schuylersg/FastDataAcquisition/README.md

FastDataAcquisition
===================

A high speed (1 GSPS+) data acquisition circuit. This project is currently in development. All schematics and boards are not finalized.
