schuylersg/FastDataAcquisition/FastDataAcq.brd

## EAGLE design FastDataAcq.brd (2013-11-19)

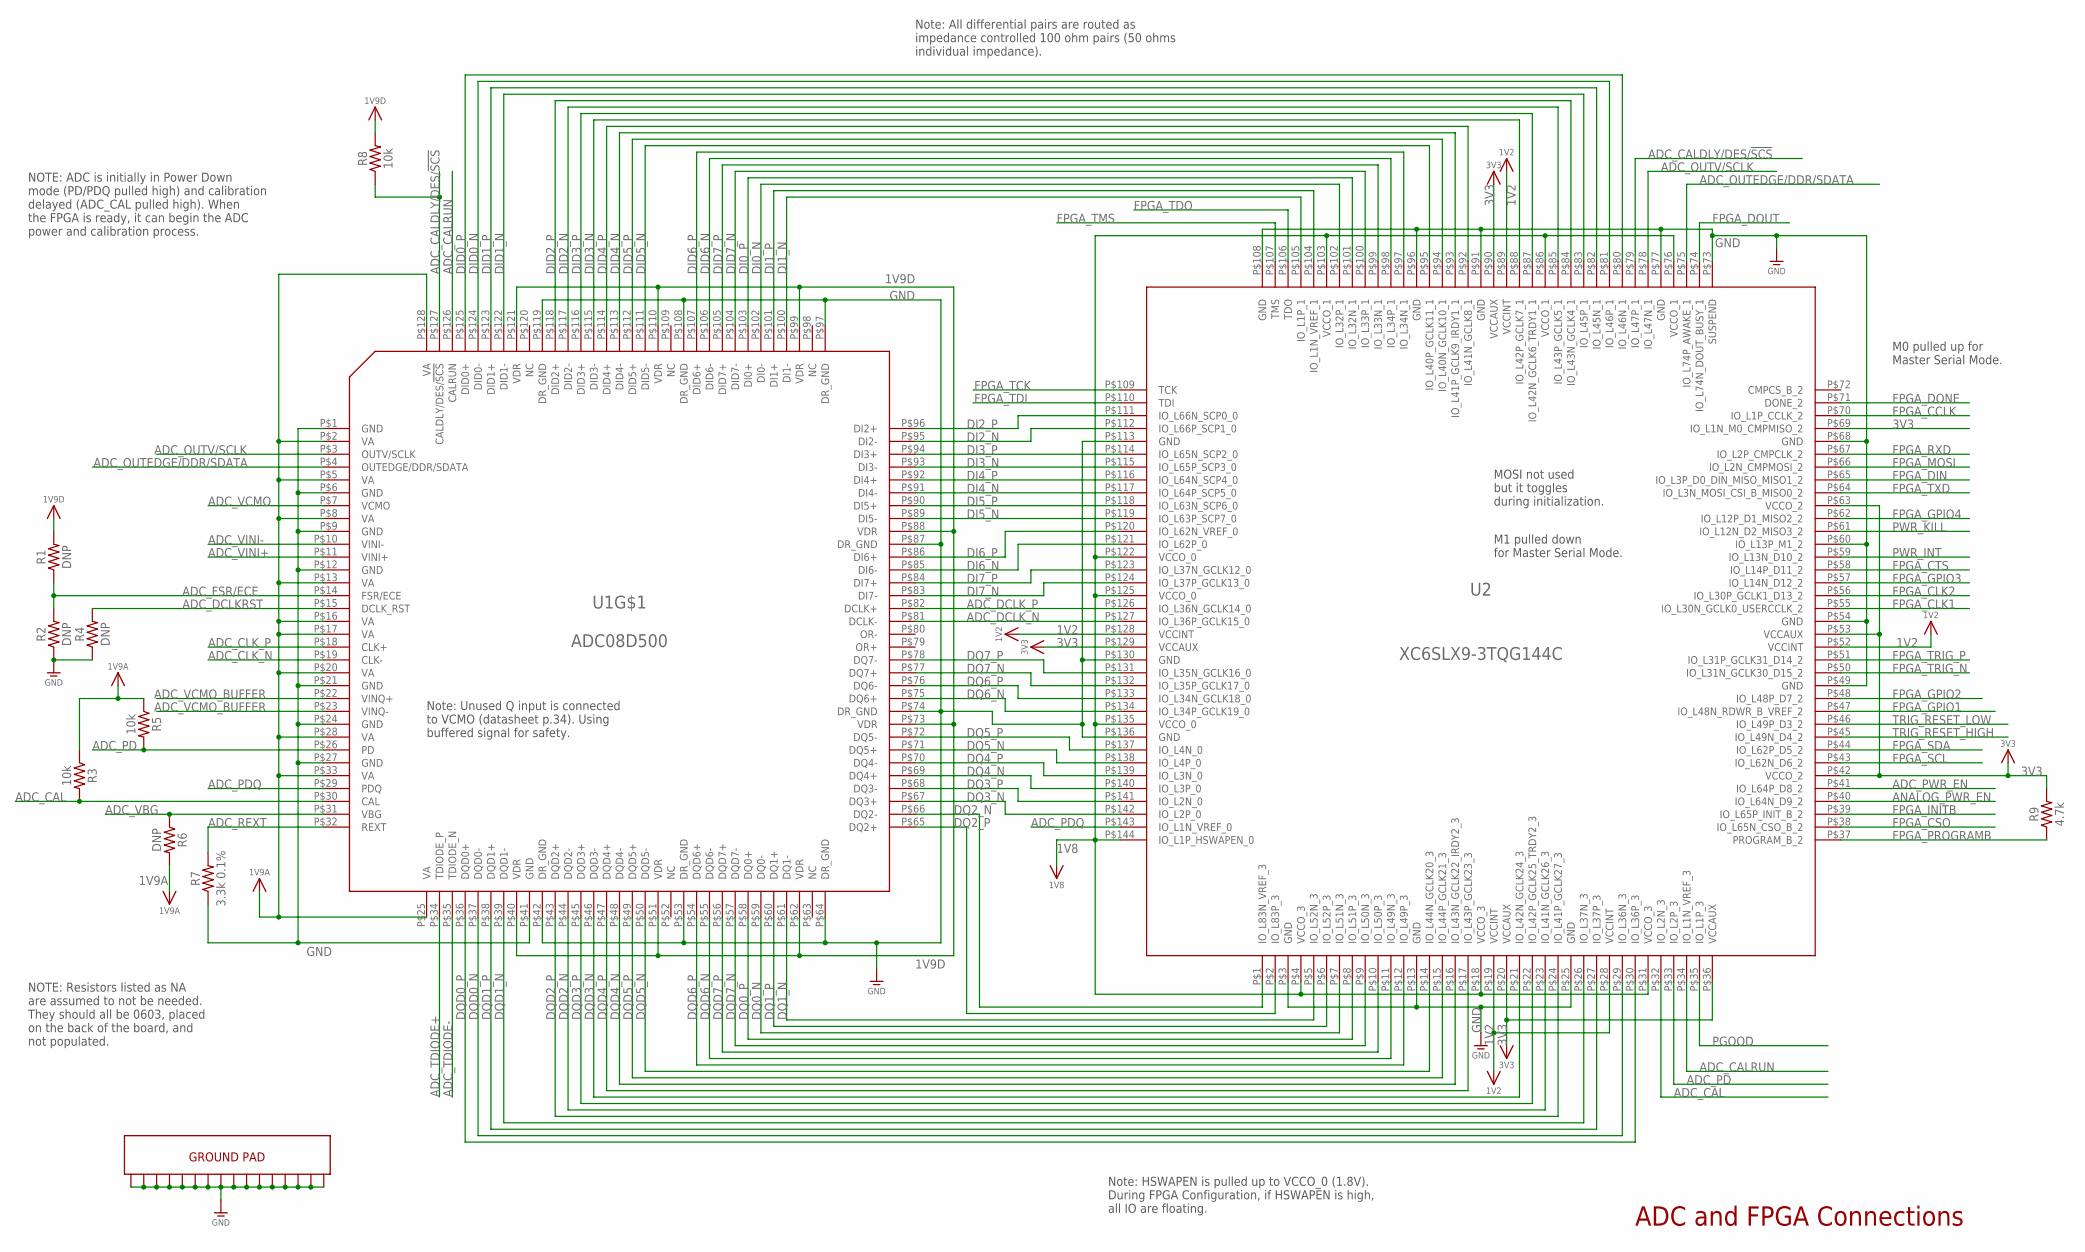
[picture p4: schematic FastDataAcq.sch, sheet 1, ADC to FPGA]

Parts:
R1, R2, R4, R6: DNP; R0603
R3, R5, R8: 10k; R0201; MANPARTNUMBER RC0603J103CS
R7: 3.3k 0.1%; R0603; PARTNUMBER P3.3KDBCT-ND
R9: 4.7k; R0201; MANPARTNUMBER ERJ-1GNJ472C
U1: ADC08D500; 128HLQFP; PARTNUMBER ADC08D500CIYB/NOPB-ND
U2: XC6SLX9-3TQG144C; TQG144

Connections:
1V2: U2.P$19 (VCCINT), U2.P$28 (VCCINT), U2.P$52 (VCCINT), U2.P$89 (VCCINT), U2.P$128 (VCCINT); also elsewhere on the board
1V8: U2.P$4 (VCCO_3), U2.P$18 (VCCO_3), U2.P$31 (VCCO_3), U2.P$76 (VCCO_1), U2.P$86 (VCCO_1), U2.P$103 (VCCO_1), U2.P$122 (VCCO_0), U2.P$125 (VCCO_0), U2.P$135 (VCCO_0), U2.P$144 (IO_L1P_HSWAPEN_0); also elsewhere on the board
1V9A: R3.1, R5.1, R6.2, U1.P$2 (VA), U1.P$5 (VA), U1.P$8 (VA), U1.P$13 (VA), U1.P$16 (VA), U1.P$17 (VA), U1.P$20 (VA), U1.P$25 (VA), U1.P$28 (VA), U1.P$33 (VA), U1.P$128 (VA); also elsewhere on the board
1V9D: R1.2, R8.2, U1.P$40 (VDR), U1.P$51 (VDR), U1.P$62 (VDR), U1.P$73 (VDR), U1.P$88 (VDR), U1.P$99 (VDR), U1.P$110 (VDR), U1.P$121 (VDR); also elsewhere on the board
3V3: R9.2, U2.P$20 (VCCAUX), U2.P$36 (VCCAUX), U2.P$42 (VCCO_2), U2.P$53 (VCCAUX), U2.P$63 (VCCO_2), U2.P$69 (IO_L1N_M0_CMPMISO_2), U2.P$90 (VCCAUX), U2.P$129 (VCCAUX); also elsewhere on the board
ADC_CAL: R3.2, U1.P$30 (CAL), U2.P$32 (IO_L2N_3)
ADC_CALDLY/DES/!SCS: R8.1, U1.P$127 (CALDLY/DES/!SCS), U2.P$79 (IO_L47P_1)
ADC_CALRUN: U1.P$126 (CALRUN), U2.P$34 (IO_L1N_VREF_3)
ADC_CLK_N: U1.P$19 (CLK-); also elsewhere on the board
ADC_CLK_P: U1.P$18 (CLK+); also elsewhere on the board
ADC_DCLKRST: R4.2, U1.P$15 (DCLK_RST)
ADC_DCLK_N: U1.P$81 (DCLK-), U2.P$127 (IO_L36P_GCLK15_0)
ADC_DCLK_P: U1.P$82 (DCLK+), U2.P$126 (IO_L36N_GCLK14_0)
ADC_FSR/ECE: R1.1, R2.2, U1.P$14 (FSR/ECE)
ADC_OUTEDGE/DDR/SDATA: U1.P$4 (OUTEDGE/DDR/SDATA), U2.P$75 (IO_L74P_AWAKE_1)
ADC_OUTV/SCLK: U1.P$3 (OUTV/SCLK), U2.P$78 (IO_L47N_1)
ADC_PD: R5.2, U1.P$26 (PD), U2.P$33 (IO_L2P_3)
ADC_PDQ: U1.P$29 (PDQ), U2.P$143 (IO_L1N_VREF_0)
ADC_PWR_EN: U2.P$41 (IO_L64P_D8_2); also elsewhere on the board
ADC_REXT: R7.2, U1.P$32 (REXT)
ADC_TDIODE+: U1.P$34 (TDIODE_P); also elsewhere on the board
ADC_TDIODE-: U1.P$35 (TDIODE_N); also elsewhere on the board
ADC_VBG: R6.1, U1.P$31 (VBG)
ADC_VCMO: U1.P$7 (VCMO); also elsewhere on the board
ADC_VCMO_BUFFER: U1.P$22 (VINQ+), U1.P$23 (VINQ-); also elsewhere on the board
ADC_VINI+: U1.P$11 (VINI+); also elsewhere on the board
ADC_VINI-: U1.P$10 (VINI-); also elsewhere on the board
ANALOG_PWR_EN: U2.P$40 (IO_L64N_D9_2); also elsewhere on the board
DI0_N: U1.P$102 (DI0-), U2.P$102 (IO_L32P_1)
DI0_P: U1.P$103 (DI0+), U2.P$101 (IO_L32N_1)
DI1_N: U1.P$100 (DI1-), U2.P$105 (IO_L1P_1)
DI1_P: U1.P$101 (DI1+), U2.P$104 (IO_L1N_VREF_1)
DI2_N: U1.P$95 (DI2-), U2.P$112 (IO_L66P_SCP1_0)
DI2_P: U1.P$96 (DI2+), U2.P$111 (IO_L66N_SCP0_0)
DI3_N: U1.P$93 (DI3-), U2.P$115 (IO_L65P_SCP3_0)
DI3_P: U1.P$94 (DI3+), U2.P$114 (IO_L65N_SCP2_0)
DI4_N: U1.P$91 (DI4-), U2.P$117 (IO_L64P_SCP5_0)
DI4_P: U1.P$92 (DI4+), U2.P$116 (IO_L64N_SCP4_0)
DI5_N: U1.P$89 (DI5-), U2.P$119 (IO_L63P_SCP7_0)
DI5_P: U1.P$90 (DI5+), U2.P$118 (IO_L63N_SCP6_0)
DI6_N: U1.P$85 (DI6-), U2.P$121 (IO_L62P_0)
DI6_P: U1.P$86 (DI6+), U2.P$120 (IO_L62N_VREF_0)
DI7_N: U1.P$83 (DI7-), U2.P$124 (IO_L37P_GCLK13_0)
DI7_P: U1.P$84 (DI7+), U2.P$123 (IO_L37N_GCLK12_0)
DID0_N: U1.P$124 (DID0-), U2.P$81 (IO_L46P_1)
DID0_P: U1.P$125 (DID0+), U2.P$80 (IO_L46N_1)
DID1_N: U1.P$122 (DID1-), U2.P$83 (IO_L45P_1)
DID1_P: U1.P$123 (DID1+), U2.P$82 (IO_L45N_1)
DID2_N: U1.P$117 (DID2-), U2.P$85 (IO_L43P_GCLK5_1)
DID2_P: U1.P$118 (DID2+), U2.P$84 (IO_L43N_GCLK4_1)
DID3_N: U1.P$115 (DID3-), U2.P$88 (IO_L42P_GCLK7_1)
DID3_P: U1.P$116 (DID3+), U2.P$87 (IO_L42N_GCLK6_TRDY1_1)
DID4_N: U1.P$113 (DID4-), U2.P$93 (IO_L41P_GCLK9_IRDY1_1)
DID4_P: U1.P$114 (DID4+), U2.P$92 (IO_L41N_GCLK8_1)
DID5_N: U1.P$111 (DID5-), U2.P$95 (IO_L40P_GCLK11_1)
DID5_P: U1.P$112 (DID5+), U2.P$94 (IO_L40N_GCLK10_1)
DID6_N: U1.P$106 (DID6-), U2.P$98 (IO_L34P_1)
DID6_P: U1.P$107 (DID6+), U2.P$97 (IO_L34N_1)
DID7_N: U1.P$104 (DID7-), U2.P$100 (IO_L33P_1)
DID7_P: U1.P$105 (DID7+), U2.P$99 (IO_L33N_1)
DQ0_N: U1.P$59 (DQ0-), U2.P$7 (IO_L51N_3)
DQ0_P: U1.P$58 (DQ0+), U2.P$8 (IO_L51P_3)
DQ1_N: U1.P$61 (DQ1-), U2.P$5 (IO_L52N_3)
DQ1_P: U1.P$60 (DQ1+), U2.P$6 (IO_L52P_3)
DQ2_N: U1.P$66 (DQ2-), U2.P$1 (IO_L83N_VREF_3)
DQ2_P: U1.P$65 (DQ2+), U2.P$2 (IO_L83P_3)
DQ3_N: U1.P$67 (DQ3+), U2.P$142 (IO_L2P_0)
DQ3_P: U1.P$68 (DQ3-), U2.P$141 (IO_L2N_0)
DQ4_N: U1.P$69 (DQ4+), U2.P$140 (IO_L3P_0)
DQ4_P: U1.P$70 (DQ4-), U2.P$139 (IO_L3N_0)
DQ5_N: U1.P$71 (DQ5+), U2.P$138 (IO_L4P_0)
DQ5_P: U1.P$72 (DQ5-), U2.P$137 (IO_L4N_0)
DQ6_N: U1.P$75 (DQ6+), U2.P$134 (IO_L34P_GCLK19_0)
DQ6_P: U1.P$76 (DQ6-), U2.P$133 (IO_L34N_GCLK18_0)
DQ7_N: U1.P$77 (DQ7+), U2.P$132 (IO_L35P_GCLK17_0)
DQ7_P: U1.P$78 (DQ7-), U2.P$131 (IO_L35N_GCLK16_0)
DQD0_N: U1.P$37 (DQD0-), U2.P$29 (IO_L36N_3)
DQD0_P: U1.P$36 (DQD0+), U2.P$30 (IO_L36P_3)
DQD1_N: U1.P$39 (DQD1-), U2.P$26 (IO_L37N_3)
DQD1_P: U1.P$38 (DQD1+), U2.P$27 (IO_L37P_3)
DQD2_N: U1.P$44 (DQD2-), U2.P$23 (IO_L41N_GCLK26_3)
DQD2_P: U1.P$43 (DQD2+), U2.P$24 (IO_L41P_GCLK27_3)
DQD3_N: U1.P$46 (DQD3-), U2.P$21 (IO_L42N_GCLK24_3)
DQD3_P: U1.P$45 (DQD3+), U2.P$22 (IO_L42P_GCLK25_TRDY2_3)
DQD4_N: U1.P$48 (DQD4-), U2.P$16 (IO_L43N_GCLK22_IRDY2_3)
DQD4_P: U1.P$47 (DQD4+), U2.P$17 (IO_L43P_GCLK23_3)
DQD5_N: U1.P$50 (DQD5-), U2.P$14 (IO_L44N_GCLK20_3)
DQD5_P: U1.P$49 (DQD5+), U2.P$15 (IO_L44P_GCLK21_3)
DQD6_N: U1.P$55 (DQD6-), U2.P$11 (IO_L49N_3)
DQD6_P: U1.P$54 (DQD6+), U2.P$12 (IO_L49P_3)
DQD7_N: U1.P$57 (DQD7-), U2.P$9 (IO_L50N_3)
DQD7_P: U1.P$56 (DQD7+), U2.P$10 (IO_L50P_3)
FPGA_CCLK: U2.P$70 (IO_L1P_CCLK_2); also elsewhere on the board
FPGA_CLK1: U2.P$55 (IO_L30N_GCLK0_USERCCLK_2); also elsewhere on the board
FPGA_CLK2: U2.P$56 (IO_L30P_GCLK1_D13_2); also elsewhere on the board
FPGA_CSO: U2.P$38 (IO_L65N_CSO_B_2)
FPGA_CTS: U2.P$58 (IO_L14P_D11_2); also elsewhere on the board
FPGA_DIN: U2.P$65 (IO_L3P_D0_DIN_MISO_MISO1_2); also elsewhere on the board
FPGA_DONE: U2.P$71 (DONE_2); also elsewhere on the board
FPGA_DOUT: U2.P$74 (IO_L74N_DOUT_BUSY_1)
FPGA_GPIO1: U2.P$47 (IO_L48N_RDWR_B_VREF_2); also elsewhere on the board
FPGA_GPIO2: U2.P$48 (IO_L48P_D7_2); also elsewhere on the board
FPGA_GPIO3: U2.P$57 (IO_L14N_D12_2); also elsewhere on the board
FPGA_GPIO4: U2.P$62 (IO_L12P_D1_MISO2_2); also elsewhere on the board
FPGA_INITB: U2.P$39 (IO_L65P_INIT_B_2); also elsewhere on the board
FPGA_MOSI: U2.P$66 (IO_L2N_CMPMOSI_2)
FPGA_PROGRAMB: R9.1, U2.P$37 (PROGRAM_B_2); also elsewhere on the board
FPGA_RXD: U2.P$67 (IO_L2P_CMPCLK_2); also elsewhere on the board
FPGA_SCL: U2.P$43 (IO_L62N_D6_2); also elsewhere on the board
FPGA_SDA: U2.P$44 (IO_L62P_D5_2); also elsewhere on the board
FPGA_TCK: U2.P$109 (TCK); also elsewhere on the board
FPGA_TDI: U2.P$110 (TDI); also elsewhere on the board
FPGA_TDO: U2.P$106 (TDO); also elsewhere on the board
FPGA_TMS: U2.P$107 (TMS); also elsewhere on the board
FPGA_TRIG_N: U2.P$50 (IO_L31N_GCLK30_D15_2); also elsewhere on the board
FPGA_TRIG_P: U2.P$51 (IO_L31P_GCLK31_D14_2); also elsewhere on the board
FPGA_TXD: U2.P$64 (IO_L3N_MOSI_CSI_B_MISO0_2); also elsewhere on the board
GND: R2.1, R4.1, R7.1, U1.P$1 (GND), U1.P$6 (GND), U1.P$9 (GND), U1.P$12 (GND), U1.P$21 (GND), U1.P$24 (GND), U1.P$27 (GND), U1.P$41 (GND), U1.P$42 (DR_GND), U1.P$53 (DR_GND), U1.P$64 (DR_GND), U1.P$74 (DR_GND), U1.P$87 (DR_GND), U1.P$97 (DR_GND), U1.P$108 (DR_GND), U1.P$119 (DR_GND), U1.P$129 (GND), U1.P$130 (GND), U1.P$131 (GND), U1.P$132 (GND), U1.P$133 (GND), U1.P$134 (GND), U1.P$135 (GND), U1.P$136 (GND), U1.P$137 (GND), U1.P$138 (GND), U1.P$139 (GND), U1.P$140 (GND), U1.P$141 (GND), U1.P$142 (GND), U1.P$143 (GND), U1.P$144 (GND), U2.P$3 (GND), U2.P$13 (GND), U2.P$25 (GND), U2.P$49 (GND), U2.P$54 (GND), U2.P$60 (IO_L13P_M1_2), U2.P$68 (GND), U2.P$73 (SUSPEND), U2.P$77 (GND), U2.P$91 (GND), U2.P$96 (GND), U2.P$108 (GND), U2.P$113 (GND), U2.P$130 (GND), U2.P$136 (GND); also elsewhere on the board
PGOOD: U2.P$35 (IO_L1P_3); also elsewhere on the board
PWR_INT: U2.P$59 (IO_L13N_D10_2); also elsewhere on the board
PWR_KILL: U2.P$61 (IO_L12N_D2_MISO3_2); also elsewhere on the board
TRIG_RESET_HIGH: U2.P$45 (IO_L49N_D4_2); also elsewhere on the board
TRIG_RESET_LOW: U2.P$46 (IO_L49P_D3_2); also elsewhere on the board

Notes on the sheet:
ADC and FPGA Connections
Note: Unused Q input is connected to VCMO (datasheet p.34). Using buffered signal for safety.
MOSI not used but it toggles during initialization.
M0 pulled up for Master Serial Mode.
M1 pulled down for Master Serial Mode.
Note: HSWAPEN is pulled up to VCCO_0 (1.8V). During FPGA Configuration, if HSWAPEN is high, all IO are floating.
NOTE: Resistors listed as NA are assumed to not be needed. They should all be 0603, placed on the back of the board, and not populated.
NOTE: ADC is initially in Power Down mode (PD/PDQ pulled high) and calibration delayed (ADC_CAL pulled high). When the FPGA is ready, it can begin the ADC power and calibration process.
Note: All differential pairs are routed as impedance controlled 100 ohm pairs (50 ohms individual impedance).

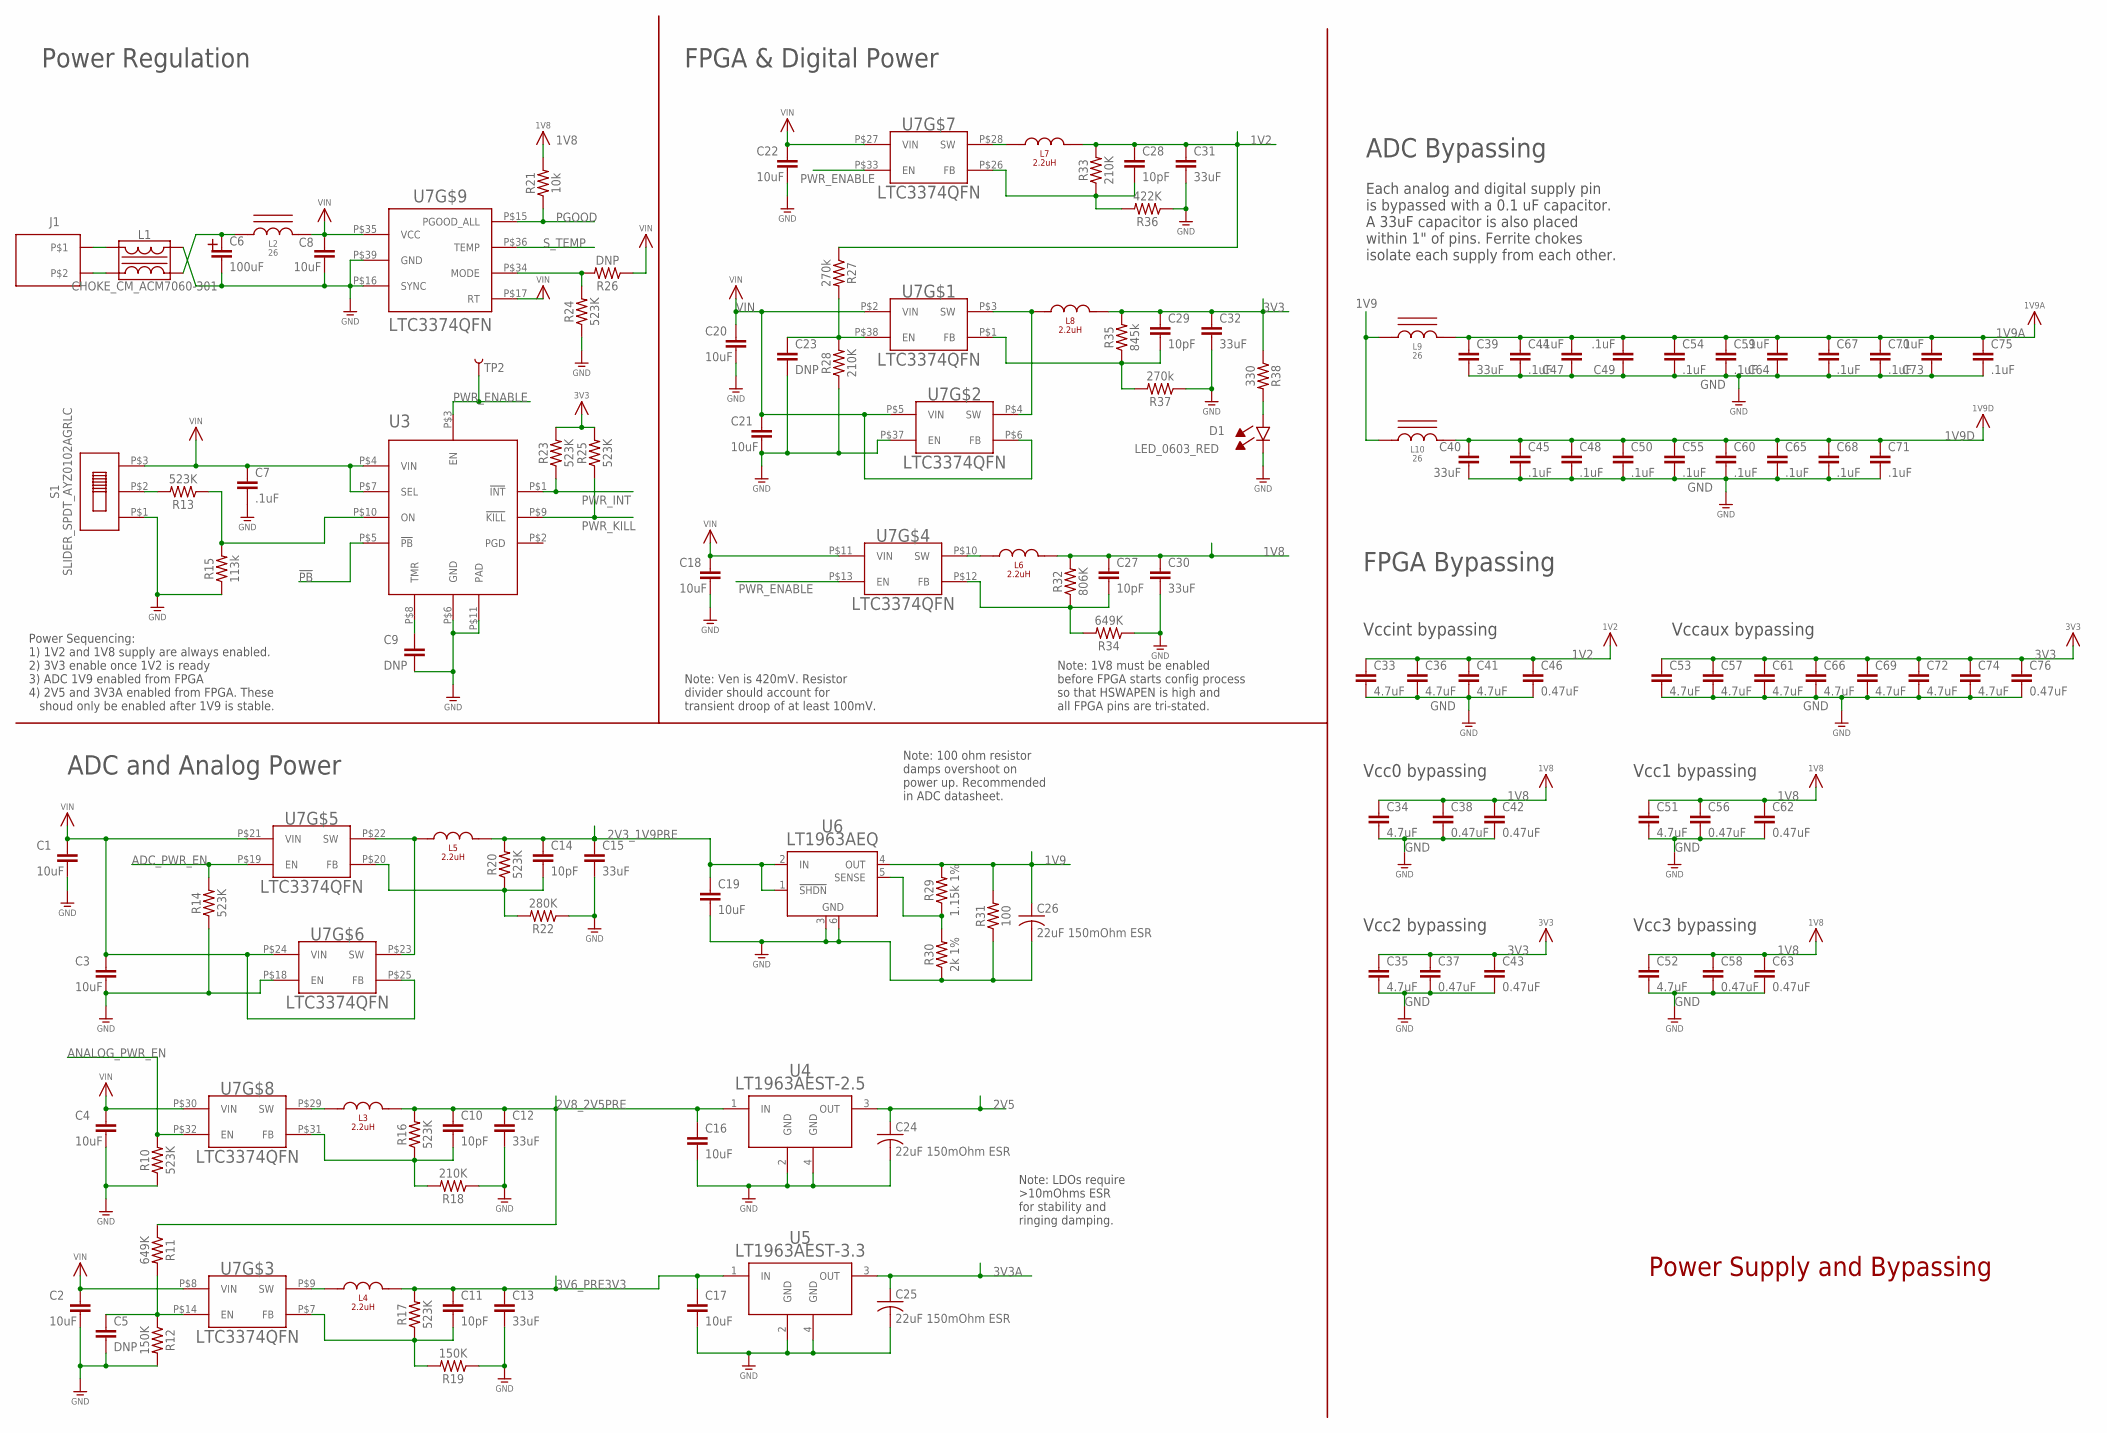
[picture p5: schematic FastDataAcq.sch, sheet 2, Power and Bypassing]

Parts:
C1, C2, C3, C4, C8, C16, C17, C18, C19, C20, C21, C22: 10uF; C0603; PARTNUMBER 445-4112-1-ND
C5, C9, C23: DNP; C0603
C6: 100uF; 2917_MURATA_CAP; MANPARTNUMBER ECASD91B107M012K00
C7, C44, C45, C47, C48, C49, C50, C54, C55, C59, C60, C64, C65, C67, C68, C70, C71, C73, C75: .1uF; 0204REVERSE; PARTNUMBER 587-2152-1-ND
C10, C11, C14, C27, C28, C29: 10pF; C0201; PARTNUMBER 445-1769-1-ND
C12, C13, C15, C30, C31, C32, C39, C40: 33uF; 0805; PARTNUMBER 445-8238-1-ND
C24, C25, C26: 22uF 150mOhm ESR; C0805; PARTNUMBER P16231CT-ND
C33, C34, C35, C36, C41, C51, C52, C53, C57, C61, C66, C69, C72, C74: 4.7uF; 0402_C; MANPARTNUMBER CL05A475MQ5NRNC
C37, C38, C42, C43, C46, C56, C58, C62, C63, C76: 0.47uF; 0204REVERSE; PARTNUMBER 1276-1779-1-ND
D1: LED_0603_RED; 0603_LED; PARTNUMBER LNJ237W82RACT-ND
J1: MICRO-FIT_3.0_2POS_RA_SMD; MICRO-FIT_3.02POS_RA_SMD
L1: CHOKE_CM_ACM7060-301; ACM7060_CHOKE
L2, L9, L10: 26; MURATA_BLM18
L3, L4, L6, L7: 2.2uH; 3.0X3.6_VISHAY; PARTNUMBER 541-1322-1-ND
L5, L8: 2.2uH; 5.18X5.49_VISHAY; PARTNUMBER 541-1220-1-ND
R10, R13, R14, R16, R17, R20, R23, R24, R25: 523K; R0201; PARTNUMBER P523KABCT-ND
R11, R34: 649K; R0201; PARTNUMBER P649KABCT-ND
R12, R19: 150K; R0201; PARTNUMBER 1276-3719-1-ND
R15: 113k; R0201; PARTNUMBER P113KABCT-ND
R18, R28, R33: 210K; R0201; PARTNUMBER P210KABCT-ND
R21: 10k; R0201; MANPARTNUMBER RC0603J103CS
R22: 280K; R0201; PARTNUMBER P280KABCT-ND
R26: DNP; R0603
R27, R37: 270k; R0201; PARTNUMBER P270KABCT-ND
R29: 1.15k 1%; R0603; MANPARTNUMBER RC1608F1151CS
R30: 2k 1%; R0603; MANPARTNUMBER RC1608F202CS
R31: 100; R0603; MANPARTNUMBER RC1608J101CS
R32: 806K; R0201; PARTNUMBER P806KABCT-ND
R35: 845k; R0201; PARTNUMBER P845KABCT-ND
R36: 422K; R0201; PARTNUMBER P442KABCT-ND
R38: 330; R0201; MANPARTNUMBER RC0603J331CS
S1: SLIDER_SPDT_AYZ0102AGRLC; AYZ0102AGRLC
TP2: TEST-POINT3; PAD.03X.03
U3: LTC2955-1; 10-DFN
U4: LT1963AEST-2.5; SOT223
U5: LT1963AEST-3.3; SOT223
U6: LT1963AEQ; Q5-DD; MANPARTNUMBER LT1963AEQ#PBF
U7: LTC3374QFN; 38-QFN_(5X7)

Connections:
1V2: C28.1, C31.1, C33.P$1 (1), C36.P$1 (1), C41.P$1 (1), C46.P$1 (1), L7.P$2, R27.1, R33.2; also elsewhere on the board
1V8: C27.1, C30.1, C34.P$1 (1), C38.P$1 (1), C42.P$1 (1), C51.P$1 (1), C52.P$1 (1), C56.P$1 (1), C58.P$1 (1), C62.P$1 (1), C63.P$1 (1), L6.P$2, R21.2, R32.2; also elsewhere on the board
1V9: C26.1, L9.P$1, L10.P$1, R29.2, R31.2, U6.4 (OUT)
1V9A: C39.1, C44.P$1 (1), C47.P$2 (2), C49.P$2 (2), C54.P$1 (1), C59.P$1 (1), C64.P$2 (2), C67.P$1 (1), C70.P$1 (1), C73.P$2 (2), C75.P$1 (1), L9.P$2; also elsewhere on the board
1V9D: C40.1, C45.P$1 (1), C48.P$1 (1), C50.P$1 (1), C55.P$1 (1), C60.P$1 (1), C65.P$1 (1), C68.P$1 (1), C71.P$1 (1), L10.P$2; also elsewhere on the board
2V3_1V9PRE: C14.1, C15.1, C19.1, L5.P$2, R20.2, U6.1 (!SHDN), U6.2 (IN)
2V5: C24.1, U4.3 (OUT); also elsewhere on the board
2V8_2V5PRE: C10.1, C12.1, C16.1, L3.P$2, R11.1, R16.2, U4.1 (IN)
3V3: C29.1, C32.1, C35.P$1 (1), C37.P$1 (1), C43.P$1 (1), C53.P$1 (1), C57.P$1 (1), C61.P$1 (1), C66.P$1 (1), C69.P$1 (1), C72.P$1 (1), C74.P$1 (1), C76.P$1 (1), L8.P$2, R23.2, R25.2, R35.2, R38.1; also elsewhere on the board
3V3A: C25.1, U5.3 (OUT); also elsewhere on the board
3V6_PRE3V3: C11.1, C13.1, C17.1, L4.P$2, R17.2, U5.1 (IN)
!PB: U3.P$5 (!PB); also elsewhere on the board
ADC_PWR_EN: R14.2, U7.P$19 (EN); also elsewhere on the board
ANALOG_PWR_EN: R10.2, U7.P$32 (EN); also elsewhere on the board
GND: C1.2, C2.2, C3.2, C4.2, C5.2, C6.P$2 (NEG), C7.P$2 (2), C8.2, C9.2, C12.2, C13.2, C15.2, C16.2, C17.2, C18.2, C19.2, C20.2, C21.2, C22.2, C23.2, C24.2, C25.2, C26.2, C30.2, C31.2, C32.2, C33.P$2 (2), C34.P$2 (2), C35.P$2 (2), C36.P$2 (2), C37.P$2 (2), C38.P$2 (2), C39.2, C40.2, C41.P$2 (2), C42.P$2 (2), C43.P$2 (2), C44.P$2 (2), C45.P$2 (2), C46.P$2 (2), C47.P$1 (1), C48.P$2 (2), C49.P$1 (1), C50.P$2 (2), C51.P$2 (2), C52.P$2 (2), C53.P$2 (2), C54.P$2 (2), C55.P$2 (2), C56.P$2 (2), C57.P$2 (2), C58.P$2 (2), C59.P$2 (2), C60.P$2 (2), C61.P$2 (2), C62.P$2 (2), C63.P$2 (2), C64.P$1 (1), C65.P$2 (2), C66.P$2 (2), C67.P$2 (2), C68.P$2 (2), C69.P$2 (2), C70.P$2 (2), C71.P$2 (2), C72.P$2 (2), C73.P$1 (1), C74.P$2 (2), C75.P$2 (2), C76.P$2 (2), D1.CATHODE, L1.P$4, R10.1, R12.2, R14.1, R15.1, R18.1, R19.1, R22.1, R24.1, R28.1, R30.1, R31.1, R34.1, R36.1, R37.1, S1.P$1, U3.P$6 (GND), U3.P$11 (PAD), U4.2 (GND), U4.4 (GND), U5.2 (GND), U5.4 (GND), U6.3 (GND), U6.6 (GND), U7.P$16 (SYNC), U7.P$18 (EN), U7.P$37 (EN), U7.P$39 (GND); also elsewhere on the board
unnamed: D1.ANODE, R38.2
unnamed: R13.2, S1.P$2
unnamed: R13.1, R15.2, U3.P$10 (ON)
unnamed: R29.1, R30.2, U6.5 (SENSE)
unnamed: C9.1, U3.P$8 (TMR)
unnamed: C6.P$1 (POS), L1.P$3, L2.P$1
unnamed: J1.P$1, L1.P$1
unnamed: J1.P$2, L1.P$2
PGOOD: R21.1, U7.P$15 (PGOOD_ALL); also elsewhere on the board
PWR_ENABLE: TP2.P$1, U3.P$3 (EN), U7.P$13 (EN), U7.P$33 (EN)
PWR_INT: R23.1, U3.P$1 (!INT); also elsewhere on the board
PWR_KILL: R25.1, U3.P$9 (!KILL); also elsewhere on the board
S1EN: C23.1, R27.2, R28.2, U7.P$38 (EN)
S1FB: C29.2, R35.1, R37.2, U7.P$1 (FB)
S1SW: L8.P$1, U7.P$3 (SW), U7.P$4 (SW)
S3EN: C5.1, R11.2, R12.1, U7.P$14 (EN)
S3FB: C11.2, R17.1, R19.2, U7.P$7 (FB)
S3SW: L4.P$1, U7.P$9 (SW)
S4FB: C27.2, R32.1, R34.2, U7.P$12 (FB)
S4SW: L6.P$1, U7.P$10 (SW)
S5FB: C14.2, R20.1, R22.2, U7.P$20 (FB)
S5SW: L5.P$1, U7.P$22 (SW), U7.P$23 (SW)
S7FB: C28.2, R33.1, R36.2, U7.P$26 (FB)
S7SW: L7.P$1, U7.P$28 (SW)
S8FB: C10.2, R16.1, R18.2, U7.P$31 (FB)
S8SW: L3.P$1, U7.P$29 (SW)
S_MODE: R24.2, R26.2, U7.P$34 (MODE)
S_TEMP: U7.P$36 (TEMP); also elsewhere on the board
VIN: C1.1, C2.1, C3.1, C4.1, C7.P$1 (1), C8.1, C18.1, C20.1, C21.1, C22.1, L2.P$2, R26.1, S1.P$3, U3.P$4 (VIN), U3.P$7 (SEL), U7.P$2 (VIN), U7.P$5 (VIN), U7.P$6 (FB), U7.P$8 (VIN), U7.P$11 (VIN), U7.P$17 (RT), U7.P$21 (VIN), U7.P$24 (VIN), U7.P$25 (FB), U7.P$27 (VIN), U7.P$30 (VIN), U7.P$35 (VCC)

Notes on the sheet:
Power Supply and Bypassing
ADC Bypassing
Each analog and digital supply pin is bypassed with a 0.1 uF capacitor. A 33uF capacitor is also placed within 1" of pins. Ferrite chokes isolate each supply from each other.
FPGA Bypassing
Vccint bypassing
Vccaux bypassing
Vcc0 bypassing
Vcc1 bypassing
Vcc2 bypassing
Vcc3 bypassing
Note: Ven is 420mV. Resistor divider should account for transient droop of at least 100mV.
Power Regulation
FPGA & Digital Power
ADC and Analog Power
Note: LDOs require >10mOhms ESR for stability and ringing damping.
Power Sequencing: 1) 1V2 and 1V8 supply are always enabled. 2) 3V3 enable once 1V2 is ready 3) ADC 1V9 enabled from FPGA 4) 2V5 and 3V3A enabled from FPGA. These shoud only be enabled after 1V9 is stable.
Note: 100 ohm resistor damps overshoot on power up. Recommended in ADC datasheet.
Note: 1V8 must be enabled before FPGA starts config process so that HSWAPEN is high and all FPGA pins are tri-stated.

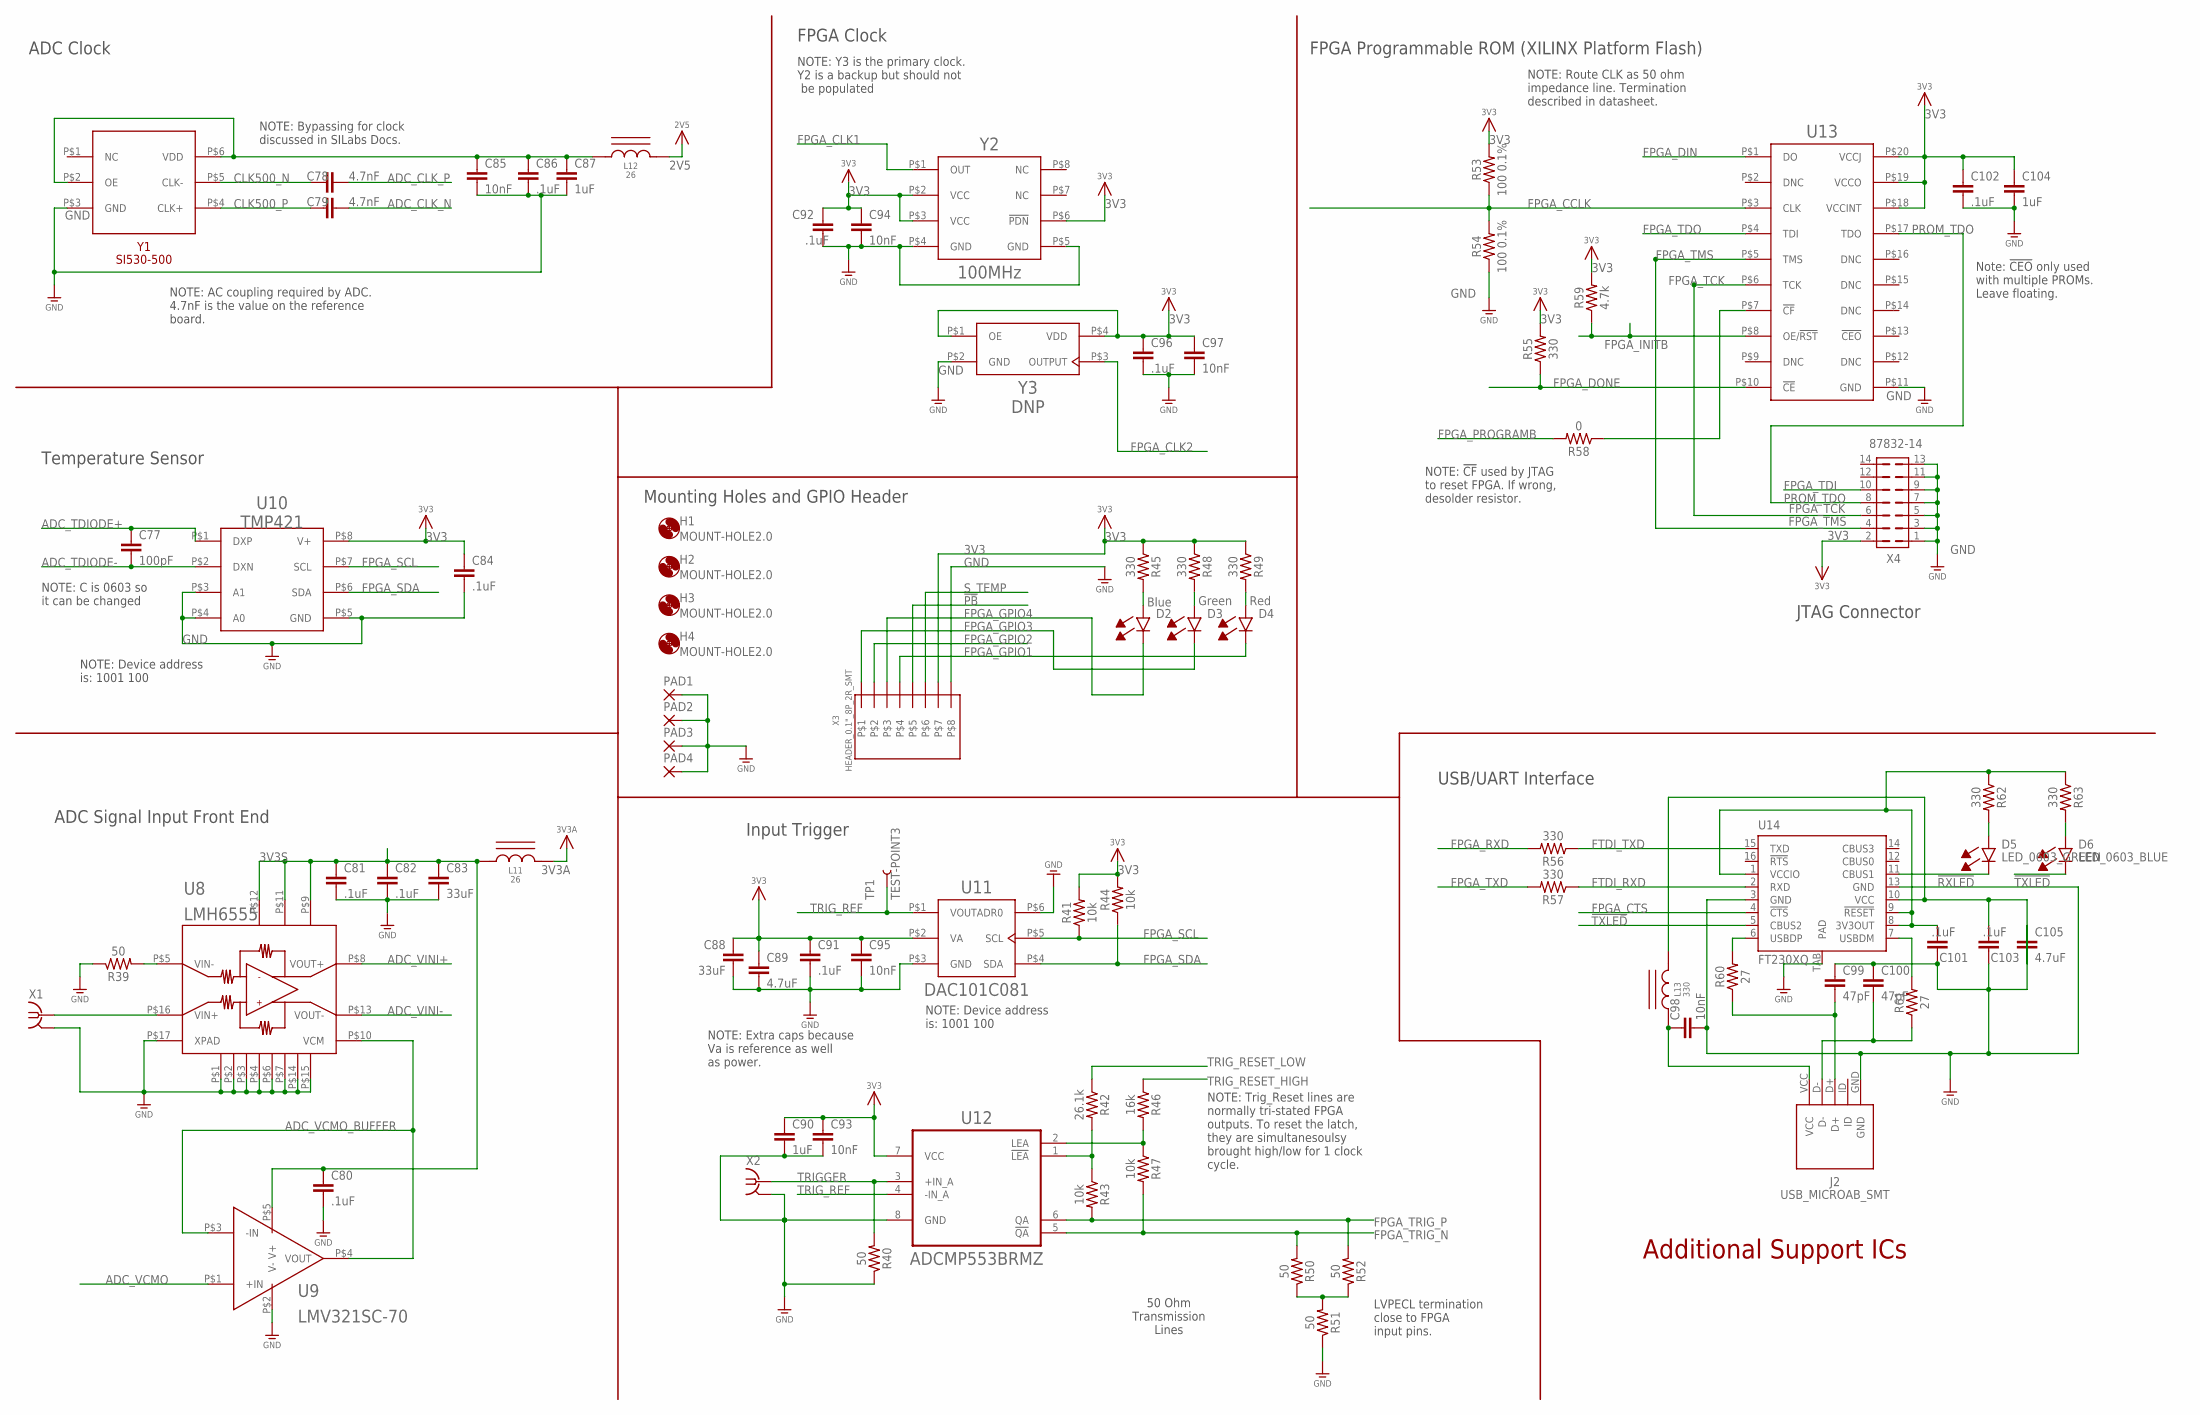
[picture p6: schematic FastDataAcq.sch, sheet 3, Ancillary Circuits (clocks, ADC front end, PROM, USB, etc.)]

Parts:
C77: 100pF; C0201; PARTNUMBER 445-4675-1-ND
C78, C79: 4.7nF; C0201; PARTNUMBER 445-13726-1-ND
C80, C81, C82, C84, C86, C91, C92, C96, C101, C102, C103: .1uF; 0204REVERSE; PARTNUMBER 587-2152-1-ND
C83, C88: 33uF; 0805; PARTNUMBER 445-8238-1-ND
C85, C93, C94, C95, C97, C98: 10nF; C0201; PARTNUMBER 445-1793-1-ND
C87, C90, C104: 1uF; 0204REVERSE; PARTNUMBER 445-9091-1-ND
C89, C105: 4.7uF; 0402_C; MANPARTNUMBER CL05A475MQ5NRNC
C99, C100: 47pF; C0201; PARTNUMBER 445-1782-1-ND
D2, D6: LED_0603_BLUE; 0603_LED
D3, D5: LED_0603_GREEN; 0603_LED
D4: LED_0603_RED; 0603_LED; PARTNUMBER LNJ237W82RACT-ND
H1, H2, H3, H4: MOUNT-HOLE2.0; 2.0
J2: USB_MICROAB_SMT; USB_MICROAB_SMT_1
L11, L12: 26; MURATA_BLM18
L13: 330; MURATA_BLM18
PAD1, PAD2, PAD3, PAD4: SMD2; SMD1,27-2,54
R39, R40, R50, R51, R52: 50; R0201; MANPARTNUMBER RC0603F49R9C
R41, R43, R44, R47: 10k; R0201; MANPARTNUMBER RC0603J103CS
R42: 26.1k; R0603; PARTNUMBER 1276-4779-1-ND
R45, R48, R49, R55, R56, R57, R62, R63: 330; R0201; MANPARTNUMBER RC0603J331CS
R46: 16k; R0603; PARTNUMBER 1276-5091-1-ND
R53, R54: 100 0.1%; R0402; MANPARTNUMBER ERA-2AEB101X
R58: 0; R0603; PARTNUMBER 311-0.0GRCT-ND
R59: 4.7k; R0201; MANPARTNUMBER ERJ-1GNJ472C
R60, R61: 27; R0201; PARTNUMBER 1276-3577-1-ND
TP1: TEST-POINT3; PAD.03X.03
U8: LMH6555; 16WQFN
U9: LMV321SC-70; SC-70
U10: TMP421; SOT23-8
U11: DAC101C081; SOT23-6
U12: ADCMP553BRMZ; SOP65P490X110-8N
U13: XCFXXS04; TSSOP20_XILINX
U14: FT230XQ; QFN16
X1, X2: SMA-142-0701-801/806; J502-ND-142-0701-801/806; MANPARTNUMBER 142-0701-801
X3: HEADER_0.1"_8P_2R_SMT; HEADER_8P_2R_SMT
X4: 87832-14; PARTNUMBER 57J0374
Y1: SI530-500; SI530
Y2: 100MHz; UMAX8
Y3: DNP; SI500S

Connections:
2V5: L12.P$2; also elsewhere on the board
2V5A: C85.1, C86.P$1 (1), C87.P$1 (1), L12.P$1, Y1.P$2 (OE), Y1.P$6 (VDD)
3V3: C84.P$1 (1), C88.1, C89.P$1 (1), C90.P$1 (1), C91.P$1 (1), C92.P$1 (1), C93.1, C94.1, C95.1, C96.P$1 (1), C97.1, C102.P$1 (1), C104.P$1 (1), R41.2, R44.2, R45.1, R48.1, R49.1, R53.2, R55.2, R59.2, U10.P$8 (V+), U11.P$2 (VA), U12.7 (VCC), U13.P$18 (VCCINT), U13.P$19 (VCCO), U13.P$20 (VCCJ), X3.P$7, X4.2, Y2.P$2 (VCC), Y2.P$3 (VCC), Y2.P$6 (!PDN), Y3.P$1 (OE), Y3.P$4 (VDD); also elsewhere on the board
3V3A: L11.P$2; also elsewhere on the board
3V3OUT: C101.P$2 (2), R62.1, R63.1, U14.1 (VCCIO), U14.8 (3V3OUT), U14.9 (!RESET)
3V3S: C80.P$1 (1), C81.P$1 (1), C82.P$1 (1), C83.1, L11.P$1, U8.P$9 (VCC), U8.P$11 (VCC), U8.P$12 (VCC), U9.P$5 (V+)
5VUSB: C103.P$2 (2), C105.P$2 (2), L13.P$2, U14.10 (VCC)
5VUSB_CON: C98.1, J2.VCC, L13.P$1
!PB: X3.P$5; also elsewhere on the board
!RXLED: D5.CATHODE, U14.11 (CBUS1)
!TXLED: D6.CATHODE, U14.5 (CBUS2)
ADC_CLK_N: C79.2; also elsewhere on the board
ADC_CLK_P: C78.2; also elsewhere on the board
ADC_TDIODE+: C77.1, U10.P$1 (DXP); also elsewhere on the board
ADC_TDIODE-: C77.2, U10.P$2 (DXN); also elsewhere on the board
ADC_VCMO: U9.P$1 (+IN); also elsewhere on the board
ADC_VCMO_BUFFER: U8.P$10 (VCM), U9.P$3 (-IN), U9.P$4 (VOUT); also elsewhere on the board
ADC_VINI+: U8.P$8 (VOUT+); also elsewhere on the board
ADC_VINI-: U8.P$13 (VOUT-); also elsewhere on the board
CLK500_N: C78.1, Y1.P$5 (CLK-)
CLK500_P: C79.1, Y1.P$4 (CLK+)
FPGA_CCLK: R53.1, R54.2, U13.P$3 (CLK); also elsewhere on the board
FPGA_CLK1: Y2.P$1 (OUT); also elsewhere on the board
FPGA_CLK2: Y3.P$3 (OUTPUT); also elsewhere on the board
FPGA_CTS: U14.4 (!CTS); also elsewhere on the board
FPGA_DIN: U13.P$1 (DO); also elsewhere on the board
FPGA_DONE: R55.1, U13.P$10 (!CE); also elsewhere on the board
FPGA_GPIO1: D4.CATHODE, X3.P$4; also elsewhere on the board
FPGA_GPIO2: X3.P$2; also elsewhere on the board
FPGA_GPIO3: D3.CATHODE, X3.P$1; also elsewhere on the board
FPGA_GPIO4: D2.CATHODE, X3.P$3; also elsewhere on the board
FPGA_INITB: R59.1, U13.P$8 (OE/!RST); also elsewhere on the board
FPGA_PROGRAMB: R58.2; also elsewhere on the board
FPGA_RXD: R56.2; also elsewhere on the board
FPGA_SCL: R41.1, U10.P$7 (SCL), U11.P$5 (SCL); also elsewhere on the board
FPGA_SDA: R44.1, U10.P$6 (SDA), U11.P$4 (SDA); also elsewhere on the board
FPGA_TCK: U13.P$6 (TCK), X4.6; also elsewhere on the board
FPGA_TDI: X4.10; also elsewhere on the board
FPGA_TDO: U13.P$4 (TDI); also elsewhere on the board
FPGA_TMS: U13.P$5 (TMS), X4.4; also elsewhere on the board
FPGA_TRIG_N: R47.2, R50.2, U12.5 (!QA); also elsewhere on the board
FPGA_TRIG_P: R43.2, R52.2, U12.6 (QA); also elsewhere on the board
FPGA_TXD: R57.2; also elsewhere on the board
FTDI_RXD: R57.1, U14.2 (RXD)
FTDI_TXD: R56.1, U14.15 (TXD)
GND: C80.P$2 (2), C81.P$2 (2), C82.P$2 (2), C83.2, C84.P$2 (2), C85.2, C86.P$2 (2), C87.P$2 (2), C88.2, C89.P$2 (2), C90.P$2 (2), C91.P$2 (2), C92.P$2 (2), C93.2, C94.2, C95.2, C96.P$2 (2), C97.2, C98.2, C99.1, C100.1, C101.P$1 (1), C102.P$2 (2), C103.P$1 (1), C104.P$2 (2), C105.P$1 (1), J2.GND, PAD1.1, PAD2.1, PAD3.1, PAD4.1, R39.1, R40.1, R51.1, R54.1, U8.P$1 (GND), U8.P$2 (GND), U8.P$3 (GND), U8.P$4 (GND), U8.P$6 (GND), U8.P$7 (GND), U8.P$14 (GND), U8.P$15 (GND), U8.P$17 (XPAD), U9.P$2 (V-), U10.P$3 (A1), U10.P$4 (A0), U10.P$5 (GND), U11.P$3 (GND), U11.P$6 (ADR0), U12.8 (GND), U13.P$11 (GND), U14.3 (GND), U14.13 (GND), U14.TAB (PAD), X1.G@1 (2), X1.G@2 (2), X1.G@3 (2), X1.G@4 (2), X2.G@1 (2), X2.G@2 (2), X2.G@3 (2), X2.G@4 (2), X3.P$8, X4.1, X4.3, X4.5, X4.7, X4.9, X4.11, X4.13, Y1.P$3 (GND), Y2.P$4 (GND), Y2.P$5 (GND), Y3.P$2 (GND); also elsewhere on the board
unnamed: R39.2, U8.P$5 (VIN-)
unnamed: R60.2, U14.6 (USBDP)
unnamed: C99.2, J2.D+, R60.1
unnamed: C100.2, J2.D-, R61.1
unnamed: R61.2, U14.7 (USBDM)
unnamed: D5.ANODE, R62.2
unnamed: R58.1, U13.P$7 (!CF)
unnamed: D6.ANODE, R63.2
unnamed: R42.2, R43.1, U12.1 (!LEA)
unnamed: R50.1, R51.2, R52.1
unnamed: D4.ANODE, R49.2
unnamed: R46.2, R47.1, U12.2 (LEA)
unnamed: D3.ANODE, R48.2
unnamed: D2.ANODE, R45.2
PROM_TDO: U13.P$17 (TDO), X4.8
SIGNAL_IN: U8.P$16 (VIN+), X1.1
S_TEMP: X3.P$6; also elsewhere on the board
TRIGGER: R40.2, U12.3 (+IN_A), X2.1
TRIG_REF: TP1.P$1, U11.P$1 (VOUT), U12.4 (-IN_A)
TRIG_RESET_HIGH: R46.1; also elsewhere on the board
TRIG_RESET_LOW: R42.1; also elsewhere on the board

Notes on the sheet:
NOTE: Bypassing for clock discussed in SILabs Docs.
ADC Clock
NOTE: AC coupling required by ADC. 4.7nF is the value on the reference board.
ADC Signal Input Front End
NOTE: Route CLK as 50 ohm impedance line. Termination described in datasheet.
Note: !CEO! only used with multiple PROMs. Leave floating.
NOTE: !CF! used by JTAG to reset FPGA. If wrong, desolder resistor.
FPGA Programmable ROM (XILINX Platform Flash)
JTAG Connector
USB/UART Interface
FPGA Clock
NOTE: Y3 is the primary clock. Y2 is a backup but should not be populated
NOTE: C is 0603 so it can be changed
Temperature Sensor
Input Trigger
NOTE: Device address is: 1001 100
NOTE: Extra caps because Va is reference as well as power.
50 Ohm Transmission Lines
LVPECL termination close to FPGA input pins.
NOTE: Trig_Reset lines are normally tri-stated FPGA outputs. To reset the latch, they are simultanesoulsy brought high/low for 1 clock cycle.
Additional Support ICs
Mounting Holes and GPIO Header
Blue
Green
Red
