schuylersg/FastDataAcquisition/FastDataAcq.brd

## EAGLE design FastDataAcq.brd (continued)

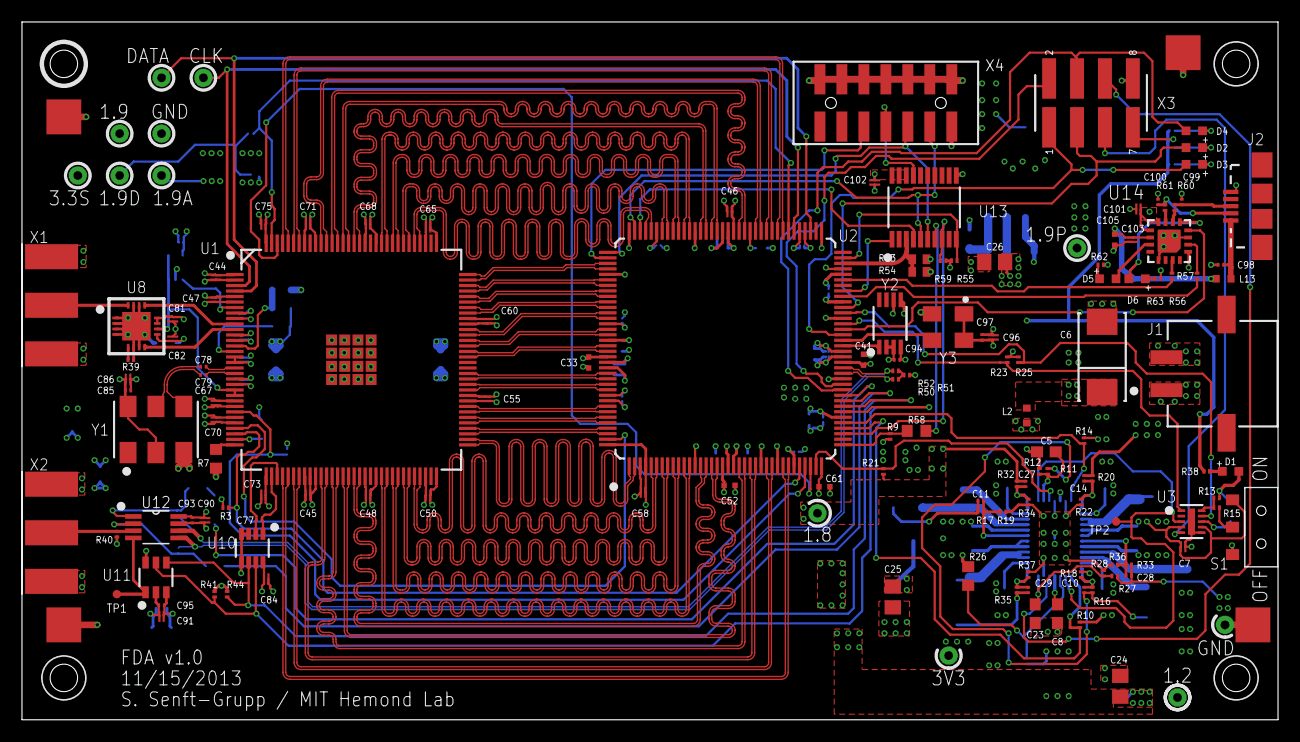
[picture p7: board FastDataAcq.brd from above]

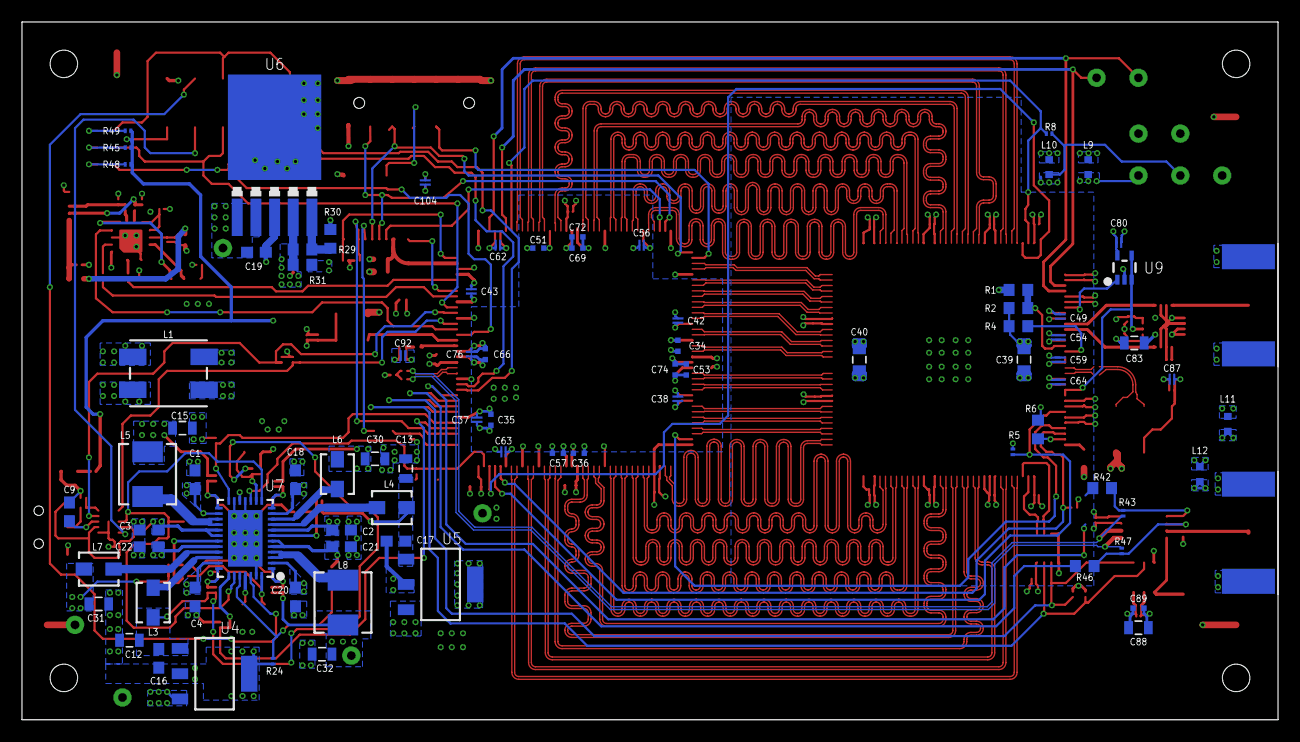
[picture p8: board FastDataAcq.brd from below]

Board: 4 copper layers, 114.3 x 63.5 mm, 221 parts (82 on the bottom side), 182 nets.
