schuylersg/FastDataAcquisition/(commit log)

2013-08-31 Initial Commit
    The first commit of the fast data acquisition (FDA) board. Schematic is
    ~80% complete and board layout is 10%. Repository is largely for backup
    purpose at this point.
    [FastDataAcqSch.brd, FastDataAcqSch.sch]
2013-09-01 Update from end of day 8/31
    Added USB/UART interface.
    [FastDataAcqSch.brd, FastDataAcqSch.sch]
2013-09-03 Update 9/2/13
    Added more ICs
    [FastDataAcqSch.brd, FastDataAcqSch.sch]
2013-09-18 Nearly finalized schematic
    [FastDataAcqSch.brd, FastDataAcqSch.sch]
2013-09-18 Only 9 parts left to source
    [FastDataAcqSch.brd, FastDataAcqSch.sch]
2013-09-19 Schematic Finalized
    [FastDataAcqSch.brd, FastDataAcqSch.sch]
2013-09-24 Changed Ferrites plus some peripherals
    [FastDataAcqSch.brd, FastDataAcqSch.sch]
2013-09-24 Unchecked Finalized Schematic
    [FastDataAcqSch.brd, FastDataAcqSch.sch]
2013-09-26 Renamed files, include PDF
    [FastDataAcq.brd, FastDataAcq.sch]
2013-09-27 Schematic fixes and beginning board layout
    [FastDataAcq.brd, FastDataAcq.sch]
2013-09-28 Board layout in progress. Other minor fixes.
    [FastDataAcq.brd, FastDataAcq.sch]
2013-10-02 Minor schematic fixes, major PCB layout changes
    [FastDataAcq.brd, FastDataAcq.sch]
2013-10-03 Now includes python layout scripts
    [FastDataAcq.brd]
2013-10-03 New power switch layout
    [FastDataAcq.sch]
2013-10-04 Component placement semi-finalized
    [FastDataAcq.brd, FastDataAcq.sch]
2013-10-05 Board layout almost complete.
    Power plane almost routes all the power correctly.
    [FastDataAcq.brd, FastDataAcq.sch]
2013-10-08 Continued board layout
    [FastDataAcq.brd, FastDataAcq.sch]
2013-10-08 Digital routing almost done.
    [FastDataAcq.brd, FastDataAcq.sch]
2013-10-09 Digital layout complete.
    [FastDataAcq.brd, FastDataAcq.sch]
2013-10-11 PCB v0.1 done
    Still need to fix a few things, but technically routing is done.
    [FastDataAcq.brd, FastDataAcq.sch]
2013-11-10 Several changes
    There are several changes after discussing the design with Grant
    Elliott. Most notably is the addition of a On/Off Debounce Latch IC.
    Additionally the CTS is now connected to the FPGA to force the packet to
    be sent.
    [FastDataAcq.brd, FastDataAcq.sch]
2013-11-12 PCB Power Layer and Other Fixes
    Finalized the FPGA GPIO Pins. Fixed power layer so that all spacing is
    equal and entire layer covered. Other cosmetic fixes.
    [FastDataAcq.brd, FastDataAcq.sch]
2013-11-12 LVDS Top Changed
    Changed LVDS data lines to 5mil width and spacing. Bend separation is
    25mil. Only the top data lines are finished - still need to do the
    bottom and sides.
    [FastDataAcq.brd, FastDataAcq.sch]
2013-11-13 Partially done with LVDS bottom half.
    [FastDataAcq.brd, FastDataAcq.sch]
2013-11-14 Finished LVDS layout.
    Making additional final changes. Still need to add test points.
    [FastDataAcq.brd, FastDataAcq.sch]
2013-11-15 Parts finalized. Layout near done.
    Still a few things on the to do list, but most tracks are final. Still
    need test points and to go over all text that's getting printed.
    [FastDataAcq.brd, FastDataAcq.sch]
2013-11-15 FDA v0.9 Ready For Quote Submission
    All that is left is shielding mounting holes.
    [FastDataAcq.brd, FastDataAcq.sch]
2013-11-16 Neatened back traces.
    [FastDataAcq.brd]
2013-11-18 Minor Changes - Fixed Screw Holes
    [FastDataAcq.brd, FastDataAcq.sch]
2013-11-18 More minor fixes.
    [FastDataAcq.brd, FastDataAcq.sch]
2013-11-19 Ready for quote submittal.
    [FastDataAcq.brd]
2013-11-19 Fixed consistency issue between sch and brd
    [FastDataAcq.sch]
